ManuelArgibay/BLDC-ESC-PCB/Control Motor BLDC.kicad_pcb

## KiCad design Control Motor BLDC.kicad_pcb (2026-10-14)

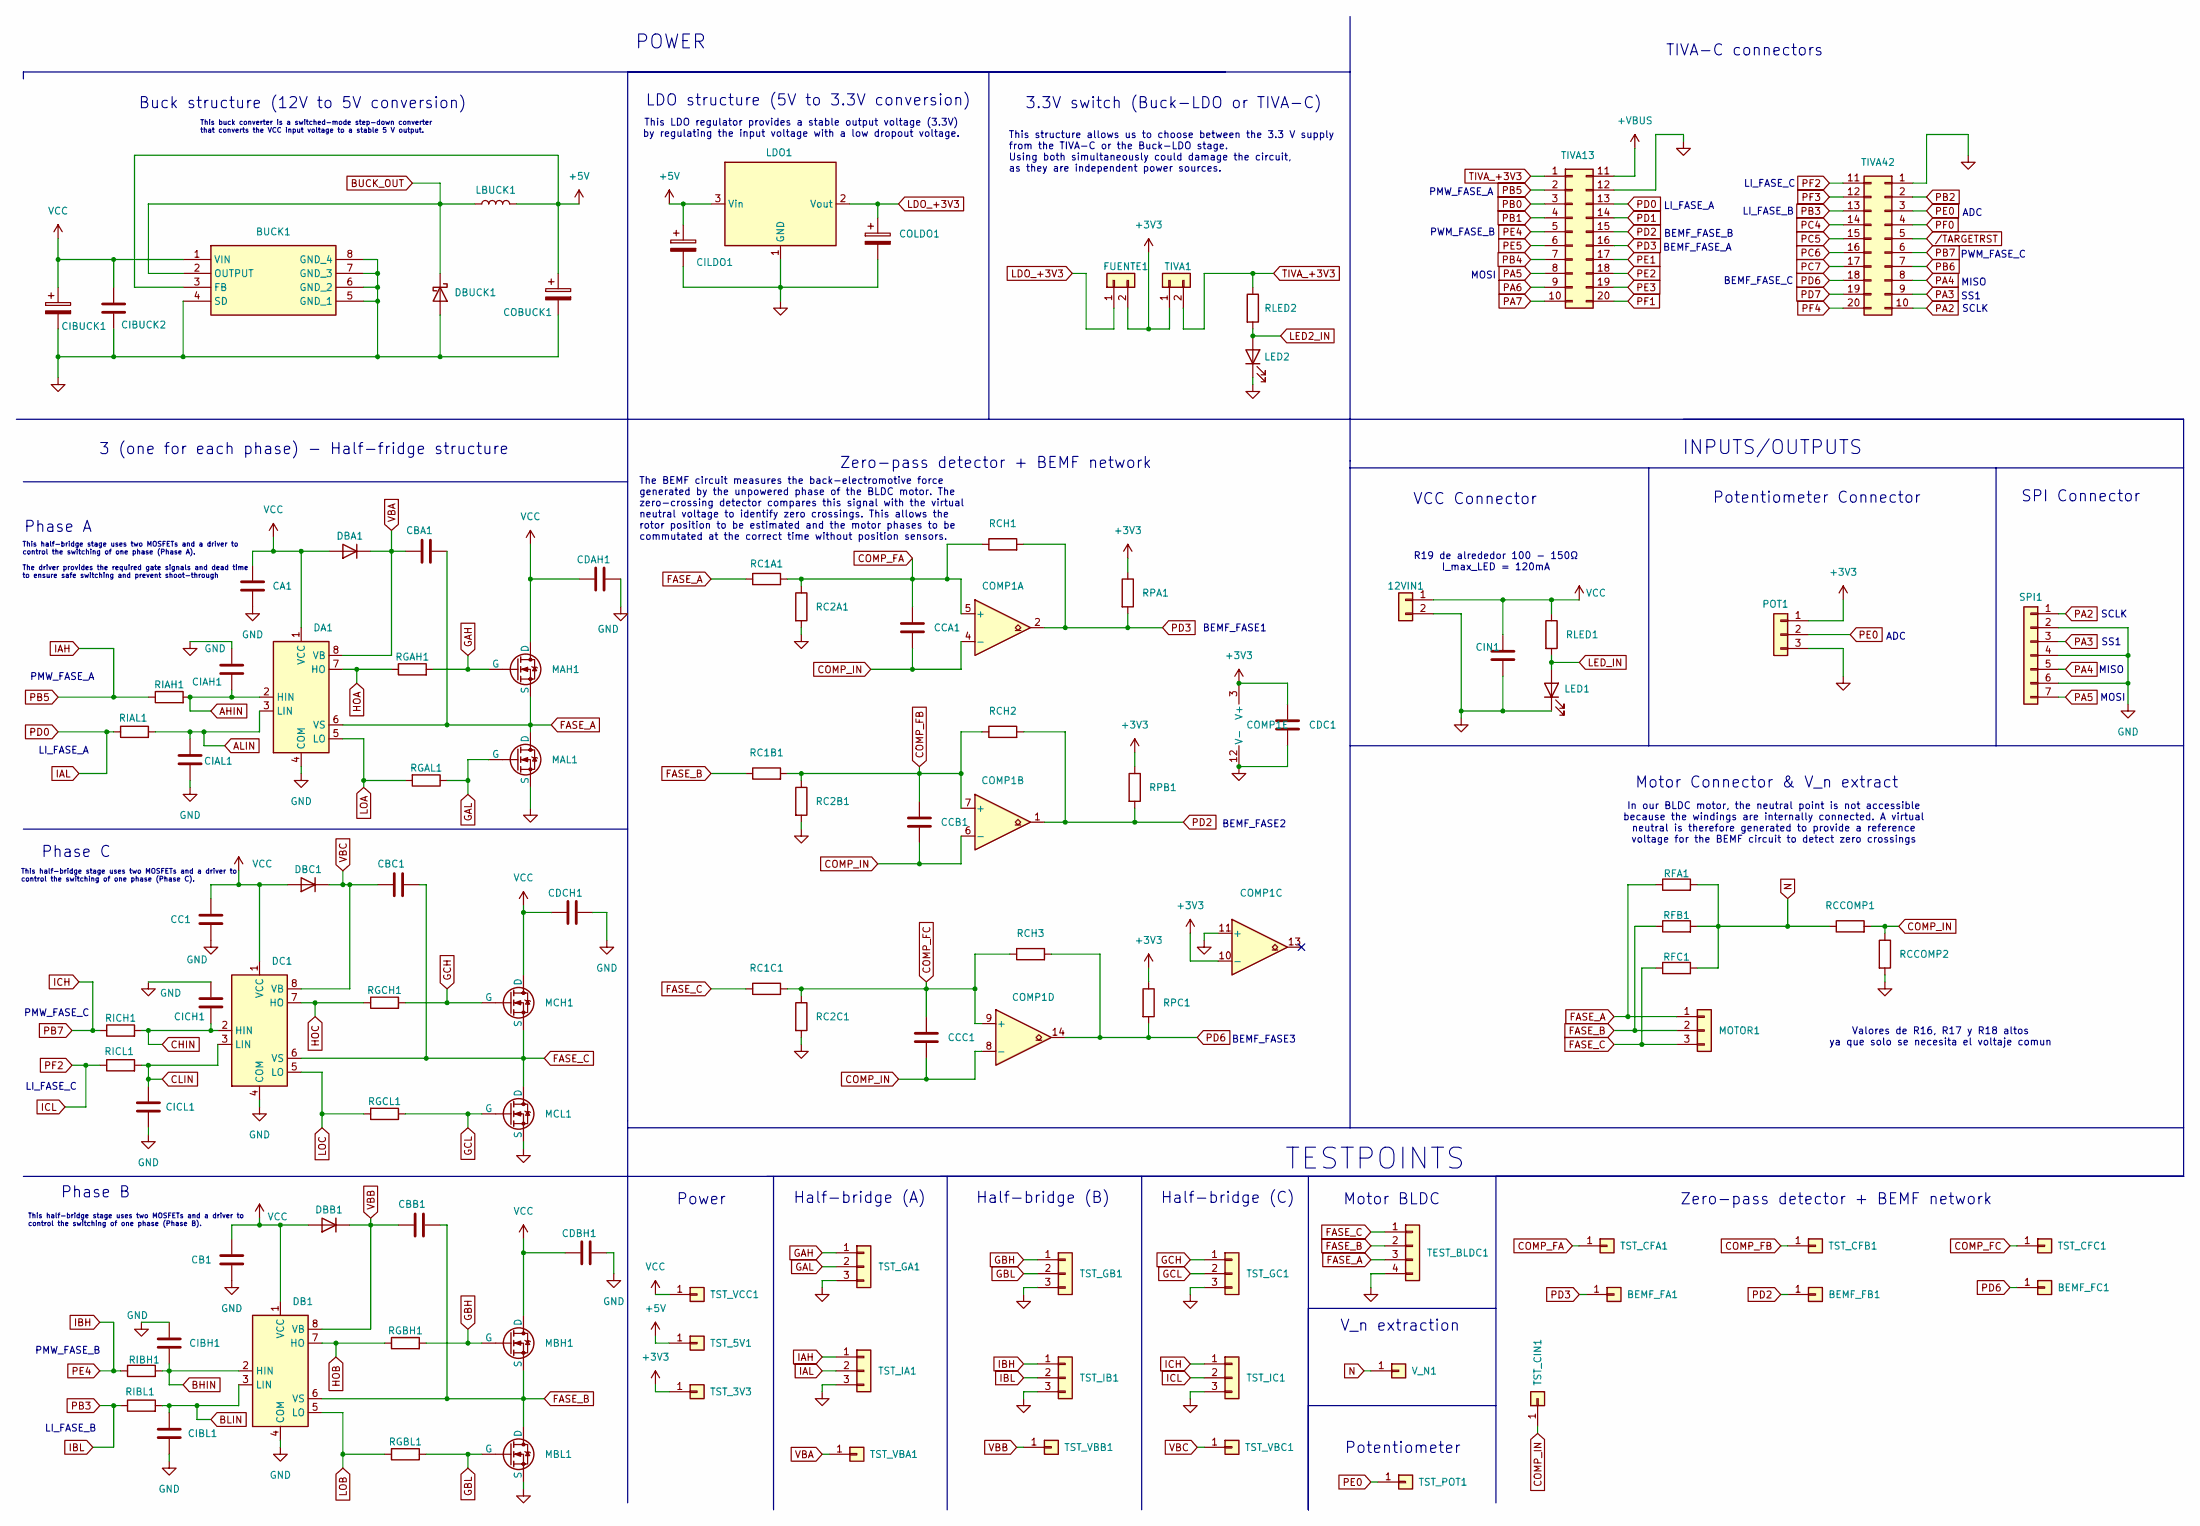
[picture p2: schematic Control Motor BLDC.kicad_sch, Placa LSE Manu & Max]

Parts:
12VIN1: Conn_01x02; TerminalBlock_Phoenix_MKDS-1,5-2-5.08_1x02_P5.08mm_Horizont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
BEMF_FA1: Conn_01x01; PinSocket_1x01_P2.54mm_Vertical
BEMF_FB1: Conn_01x01; PinSocket_1x01_P2.54mm_Vertical
BEMF_FC1: Conn_01x01; PinSocket_1x01_P2.54mm_Vertical
BUCK1: AP1509-50SG-13; SOP-8_3.76x4.96mm_P1.27mm; Mouser Part Number 621-AP1509-50SG-13
CA1: C; C_1206_3216Metric
CB1: C; C_1206_3216Metric
CBA1: C; C_1206_3216Metric
CBB1: C; C_1206_3216Metric
CBC1: C; C_1206_3216Metric
CC1: C; C_1206_3216Metric
CCA1: C; C_1206_3216Metric
CCB1: C; C_1206_3216Metric
CCC1: C; C_1206_3216Metric
CDAH1: C; C_1206_3216Metric
CDBH1: C; C_1206_3216Metric
CDC1: C; C_1206_3216Metric
CDCH1: C; C_1206_3216Metric
CIAH1: C; C_1206_3216Metric
CIAL1: C; C_1206_3216Metric
CIBH1: C; C_1206_3216Metric
CIBL1: C; C_1206_3216Metric
CIBUCK1: C_Polarized; CP_Elec_8x6.2
CIBUCK2: C; C_1206_3216Metric
CICH1: C; C_1206_3216Metric
CICL1: C; C_1206_3216Metric
CILDO1: C_Polarized; C_1206_3216Metric
CIN1: C; CP_Elec_8x6.2
COBUCK1: C_Polarized; CP_Elec_8x6.2
COLDO1: C_Polarized; C_1206_3216Metric
COMP1: LM339; SOIC-14_3.9x8.7mm_P1.27mm
DA1: IR2301; SOIC-8_3.9x4.9mm_P1.27mm
DB1: IR2301; SOIC-8_3.9x4.9mm_P1.27mm
DBA1: 1N4149; D_DO-35_SOD27_P7.62mm_Horizontal
DBB1: 1N4149; D_DO-35_SOD27_P7.62mm_Horizontal
DBC1: 1N4149; D_DO-35_SOD27_P7.62mm_Horizontal
DBUCK1: B220; D_SMB
DC1: IR2301; SOIC-8_3.9x4.9mm_P1.27mm
FUENTE1: Conn_01x02; PinHeader_1x02_P2.54mm_Vertical
LBUCK1: 47µH; Inductor
LDO1: LMS8117; SOT-223-3_TabPin2
LED1, LED2: LED; LED_D3.0mm
MAH1: NMOS
MAL1: NMOS
MBH1: NMOS
MBL1: NMOS
MCH1: NMOS
MCL1: NMOS
MOTOR1: Conn_01x03; TerminalBlock_Phoenix_MKDS-1,5-3-5.08_1x03_P5.08mm_Horizont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
POT1: Conn_01x03; TerminalBlock_Phoenix_MKDS-1,5-3-5.08_1x03_P5.08mm_Horizont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
RC1A1, RC1B1, RC1C1, RC2A1, RC2B1, RC2C1: R; R_1206_3216Metric
RCCOMP1, RCCOMP2: R; R_1206_3216Metric
RCH1, RCH2, RCH3: R; R_1206_3216Metric
RFA1: R; R_1206_3216Metric
RFB1: R; R_1206_3216Metric
RFC1: R; R_1206_3216Metric
RGAH1: R; R_1206_3216Metric
RGAL1: R; R_1206_3216Metric
RGBH1: R; R_1206_3216Metric
RGBL1: R; R_1206_3216Metric
RGCH1: R; R_1206_3216Metric
RGCL1: R; R_1206_3216Metric
RIAH1: R; R_1206_3216Metric
RIAL1: R; R_1206_3216Metric
RIBH1: R; R_1206_3216Metric
RIBL1: R; R_1206_3216Metric
RICH1: R; R_1206_3216Metric
RICL1: R; R_1206_3216Metric
RLED1, RLED2: R; R_1206_3216Metric
RPA1: R; R_1206_3216Metric
RPB1: R; R_1206_3216Metric
RPC1: R; R_1206_3216Metric
SPI1: Conn_01x07; PinHeader_1x07_P2.54mm_Vertical
TEST_BLDC1: Conn_01x04; PinHeader_1x04_P2.54mm_Vertical
TIVA1: Conn_01x02; PinHeader_1x02_P2.54mm_Vertical
TIVA13, TIVA42: Conn_02x10_Top_Bottom; PinSocket_2x10_P2.54mm_Vertical
TST_3V3, TST_5V1: Conn_01x01; PinSocket_1x01_P2.54mm_Vertical
TST_CFA1: Conn_01x01; PinSocket_1x01_P2.54mm_Vertical
TST_CFB1: Conn_01x01; PinSocket_1x01_P2.54mm_Vertical
TST_CFC1: Conn_01x01; PinSocket_1x01_P2.54mm_Vertical
TST_CIN1: Conn_01x01; PinSocket_1x01_P2.54mm_Vertical
TST_GA1: Conn_01x03; PinSocket_1x03_P2.54mm_Vertical
TST_GB1: Conn_01x03; PinSocket_1x03_P2.54mm_Vertical
TST_GC1: Conn_01x03; PinSocket_1x03_P2.54mm_Vertical
TST_IA1: Conn_01x03; PinSocket_1x03_P2.54mm_Vertical
TST_IB1: Conn_01x03; PinSocket_1x03_P2.54mm_Vertical
TST_IC1: Conn_01x03; PinSocket_1x03_P2.54mm_Vertical
TST_POT1: Conn_01x01; PinSocket_1x01_P2.54mm_Vertical
TST_VBA1: Conn_01x01; PinSocket_1x01_P2.54mm_Vertical
TST_VBB1: Conn_01x01; PinSocket_1x01_P2.54mm_Vertical
TST_VBC1: Conn_01x01; PinSocket_1x01_P2.54mm_Vertical
TST_VCC1: Conn_01x01; PinSocket_1x01_P2.54mm_Vertical
V_N1: Conn_01x01; PinSocket_1x01_P2.54mm_Vertical

Connections:
+3V3: CDC1.1, COMP1.3 (V+), COMP1.10 (-), FUENTE1.2, POT1.1, RPA1.1, RPB1.1, RPC1.1, TIVA1.1, TST_3V3.1
+5V: BUCK1.3 (FB), CILDO1.1, COBUCK1.1, LBUCK1.2, LDO1.3 (Vin), TST_5V1.1
+VBUS: TIVA13.11
AHIN: CIAH1.2, DA1.2 (HIN), RIAH1.2
ALIN: CIAL1.2, DA1.3 (LIN), RIAL1.2
BHIN: CIBH1.2, DB1.2 (HIN), RIBH1.2
BLIN: CIBL1.2, DB1.3 (LIN), RIBL1.2
BUCK_OUT: BUCK1.2 (OUTPUT), DBUCK1.1 (K), LBUCK1.1
CHIN: CICH1.2, DC1.2 (HIN), RICH1.2
CLIN: CICL1.2, DC1.3 (LIN), RICL1.2
COMP_FA: CCA1.1, COMP1.5 (+), RC1A1.2, RC2A1.1, RCH1.1, TST_CFA1.1
COMP_FB: CCB1.1, COMP1.7 (+), RC1B1.2, RC2B1.1, RCH2.1, TST_CFB1.1
COMP_FC: CCC1.1, COMP1.9 (+), RC1C1.2, RC2C1.1, RCH3.1, TST_CFC1.1
COMP_IN: CCA1.2, CCB1.2, CCC1.2, COMP1.4 (-), COMP1.6 (-), COMP1.8 (-), RCCOMP1.2, RCCOMP2.1, TST_CIN1.1
FASE_A: CBA1.2, DA1.6 (VS), MAH1.3 (S), MAL1.1 (D), MOTOR1.1, RC1A1.1, RFA1.1, TEST_BLDC1.3
FASE_B: CBB1.2, DB1.6 (VS), MBH1.3 (S), MBL1.1 (D), MOTOR1.2, RC1B1.1, RFB1.1, TEST_BLDC1.2
FASE_C: CBC1.2, DC1.6 (VS), MCH1.3 (S), MCL1.1 (D), MOTOR1.3, RC1C1.1, RFC1.1, TEST_BLDC1.1
GAH: MAH1.2 (G), RGAH1.2, TST_GA1.1
GAL: MAL1.2 (G), RGAL1.1, TST_GA1.2
GBH: MBH1.2 (G), RGBH1.2, TST_GB1.1
GBL: MBL1.2 (G), RGBL1.1, TST_GB1.2
GCH: MCH1.2 (G), RGCH1.2, TST_GC1.1
GCL: MCL1.2 (G), RGCL1.1, TST_GC1.2
GND: 12VIN1.2, BUCK1.4 (SD), BUCK1.5 (GND_1), BUCK1.6 (GND_2), BUCK1.7 (GND_3), BUCK1.8 (GND_4), CA1.2, CB1.1, CC1.1, CDAH1.2, CDBH1.2, CDC1.2, CDCH1.2, CIAH1.1, CIAL1.1, CIBH1.1, CIBL1.1, CIBUCK1.2, CIBUCK2.2, CICH1.1, CICL1.1, CILDO1.2, CIN1.2, COBUCK1.2, COLDO1.2, COMP1.11 (+), COMP1.12 (V-), DA1.4 (COM), DB1.4 (COM), DBUCK1.2 (A), DC1.4 (COM), LDO1.1 (GND), LED1.1 (K), LED2.1 (K), MAL1.3 (S), MBL1.3 (S), MCL1.3 (S), POT1.3, RC2A1.2, RC2B1.2, RC2C1.2, RCCOMP2.2, SPI1.2, SPI1.4, SPI1.6, TEST_BLDC1.4, TIVA13.12, TIVA42.1, TST_GA1.3, TST_GB1.3, TST_GC1.3, TST_IA1.3, TST_IB1.3, TST_IC1.3
HOA: DA1.7 (HO), RGAH1.1
HOB: DB1.7 (HO), RGBH1.1
HOC: DC1.7 (HO), RGCH1.1
IAH: RIAH1.1, TIVA13.2, TST_IA1.1
IAL: RIAL1.1, TIVA13.13, TST_IA1.2
IBH: RIBH1.1, TIVA13.5, TST_IB1.1
IBL: RIBL1.1, TIVA42.13, TST_IB1.2
ICH: RICH1.1, TIVA42.6, TST_IC1.1
ICL: RICL1.1, TIVA42.11, TST_IC1.2
LDO_+3V3: COLDO1.1, FUENTE1.1, LDO1.2 (Vout)
LED2_IN: LED2.2 (A), RLED2.2
LED_IN: LED1.2 (A), RLED1.2
LOA: DA1.5 (LO), RGAL1.2
LOB: DB1.5 (LO), RGBL1.2
LOC: DC1.5 (LO), RGCL1.2
N: RCCOMP1.1, RFA1.2, RFB1.2, RFC1.2, V_N1.1
PA2: SPI1.1, TIVA42.10
PA3: SPI1.3, TIVA42.9
PA4: SPI1.5, TIVA42.8
PA5: SPI1.7, TIVA13.8
PA6: TIVA13.9
PA7: TIVA13.10
PB0: TIVA13.3
PB1: TIVA13.4
PB2: TIVA42.2
PB4: TIVA13.7
PB6: TIVA42.7
PC4: TIVA42.14
PC5: TIVA42.15
PC6: TIVA42.16
PC7: TIVA42.17
PD1: TIVA13.14
PD2: BEMF_FB1.1, COMP1.1, RCH2.2, RPB1.2, TIVA13.15
PD3: BEMF_FA1.1, COMP1.2, RCH1.2, RPA1.2, TIVA13.16
PD6: BEMF_FC1.1, COMP1.14, RCH3.2, RPC1.2, TIVA42.18
PD7: TIVA42.19
PE0: POT1.2, TIVA42.3, TST_POT1.1
PE1: TIVA13.17
PE2: TIVA13.18
PE3: TIVA13.19
PE5: TIVA13.6
PF0: TIVA42.4
PF1: TIVA13.20
PF3: TIVA42.12
PF4: TIVA42.20
TIVA_+3V3: RLED2.1, TIVA1.2, TIVA13.1
VBA: CBA1.1, DA1.8 (VB), DBA1.1 (K), TST_VBA1.1
VBB: CBB1.1, DB1.8 (VB), DBB1.1 (K), TST_VBB1.1
VBC: CBC1.1, DBC1.1 (K), DC1.8 (VB), TST_VBC1.1
VCC: 12VIN1.1, BUCK1.1 (VIN), CA1.1, CB1.2, CC1.2, CDAH1.1, CDBH1.1, CDCH1.1, CIBUCK1.1, CIBUCK2.1, CIN1.1, DA1.1 (VCC), DB1.1 (VCC), DBA1.2 (A), DBB1.2 (A), DBC1.2 (A), DC1.1 (VCC), MAH1.1 (D), MBH1.1 (D), MCH1.1 (D), RLED1.1, TST_VCC1.1; also elsewhere on the board
/TARGETRST: TIVA42.5

Notes on the sheet:
Buck structure (12V to 5V conversion)
Half-bridge (A)
Phase C
Potentiometer Connector
LI_FASE_A
Phase A
Half-bridge (B)
SS1
PMW_FASE_A
PMW_FASE_C
Phase B
ADC
SPI Connector
The BEMF circuit measures the back-electromotive force generated by the unpowered phase of the BLDC motor. The zero-crossing detector compares this signal with the virtual neutral voltage to identify zero crossings. This allows the rotor position to be estimated and the motor phases to be commutate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
This half-bridge stage uses two MOSFETs and a driver to control the switching of one phase (Phase C).
Power
This structure allows us to choose between the 3.3 V supply from the TIVA-C or the Buck-LDO stage. Using both simultaneously could damage the circuit, as they are independent power sources.
MISO
Valores de R16, R17 y R18 altos ya que solo se necesita el voltaje comun
TESTPOINTS
SCLK
TIVA-C connectors
3.3V switch (Buck-LDO or TIVA-C)
BEMF_FASE_A
MOSI
VCC Connector
PWM_FASE_B
This half-bridge stage uses two MOSFETs and a driver to control the switching of one phase (Phase A). The driver provides the required gate signals and dead time to ensure safe switching and prevent shoot-through
BEMF_FASE2
Potentiometer
PWM_FASE_C
R19 de alrededor 100 - 150Ω I_max_LED = 120mA
3 (one for each phase) - Half-fridge structure
LI_FASE_C
BEMF_FASE_C
Motor Connector & V_n extract
This buck converter is a switched-mode step-down converter that converts the VCC input voltage to a stable 5 V output.
This half-bridge stage uses two MOSFETs and a driver to control the switching of one phase (Phase B).
LI_FASE_B
POWER
This LDO regulator provides a stable output voltage (3.3V) by regulating the input voltage with a low dropout voltage.
Motor BLDC
Zero-pass detector + BEMF network
BEMF_FASE1
In our BLDC motor, the neutral point is not accessible because the windings are internally connected. A virtual neutral is therefore generated to provide a reference voltage for the BEMF circuit to detect zero crossings
LDO structure (5V to 3.3V conversion)
Half-bridge (C)
PMW_FASE_B
BEMF_FASE3
V_n extraction
INPUTS/OUTPUTS
BEMF_FASE_B

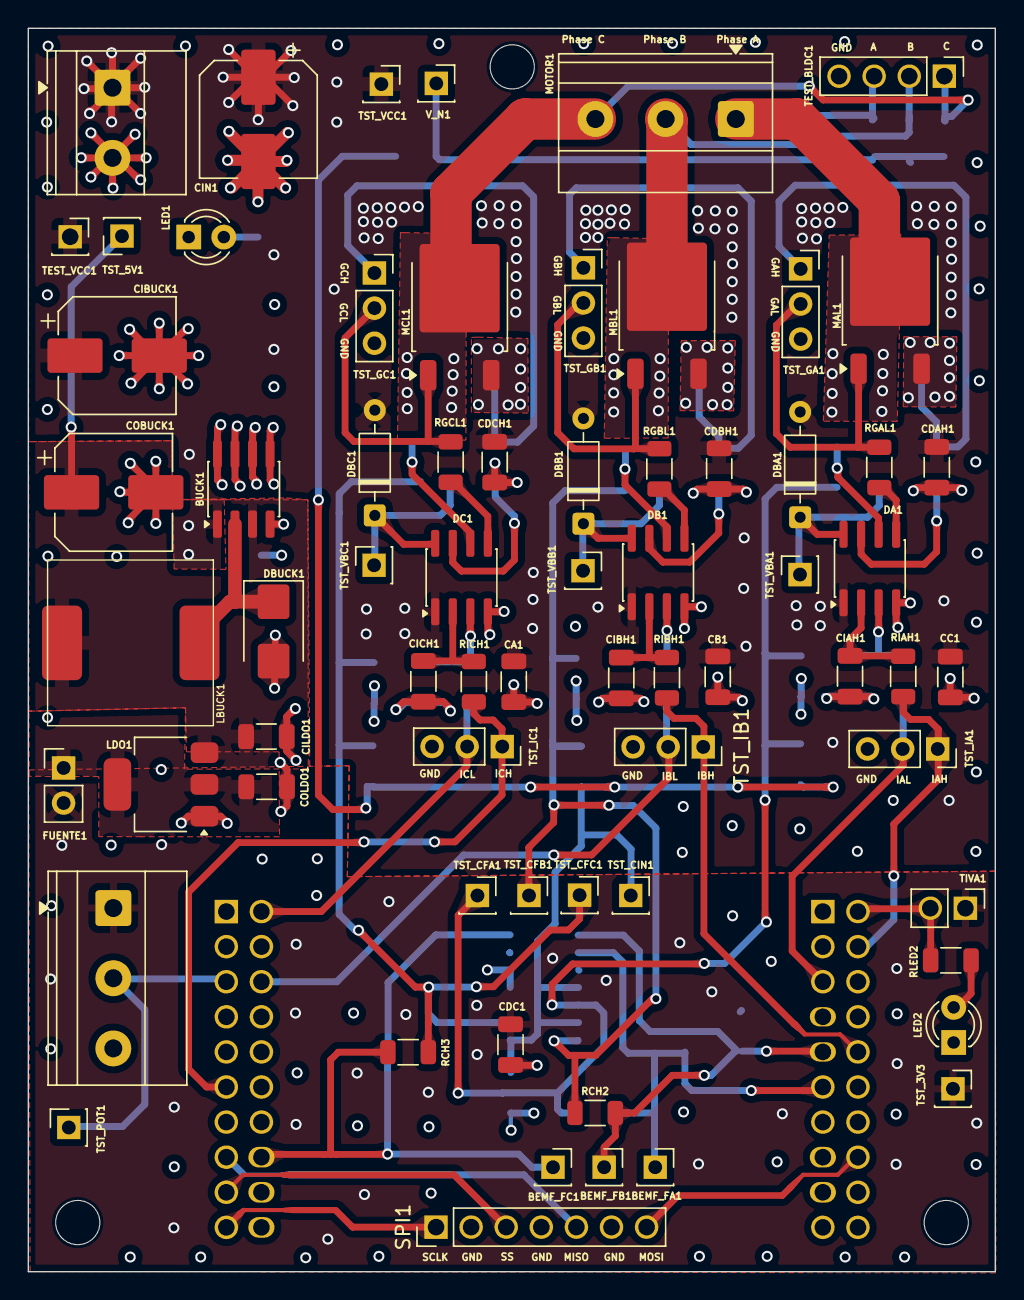
[picture p3: board Control Motor BLDC.kicad_pcb from above]

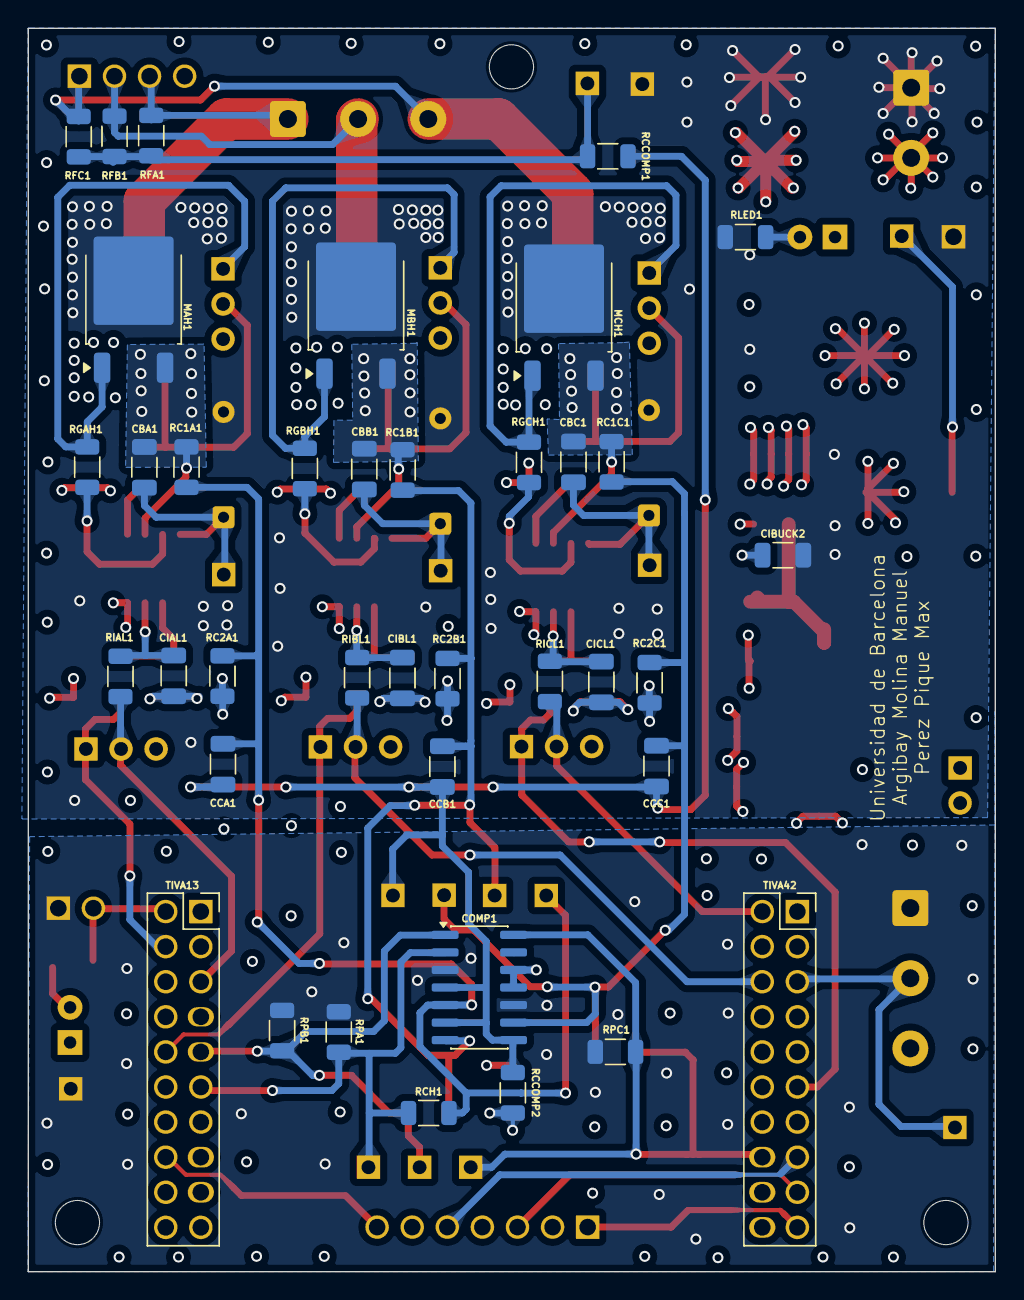
[picture p4: board Control Motor BLDC.kicad_pcb from below]

Board: 4 copper layers, 70.0 x 90.0 mm, 106 parts (38 on the bottom side), 52 nets.

Other parts of the board:
TEST_VCC1: Conn_01x01; PinSocket_1x01_P2.54mm_Vertical

Their connections:
VCC: TEST_VCC1.1; also elsewhere on the board
