ManuelArgibay/BLDC-ESC-PCB/(commit log)

2026-10-10 Proyecto KiCad del controlador BLDC sensorless (ESC) y README
    Claude-Session: https://claude.ai/code/session_013r4B2srvJtMjRWPG8WW6dN
2026-10-11 Update proyecto KiCad - revision esquematico
2026-10-12 Elimino schematics innecesarios
2026-10-12 Corrijo errores de la placa (0 errors, 0 warnings)
2026-10-18 Update
    Se ha acabado la funcion init_GPIOs e init_sys. Falta la de init_clocks y probar el PWM.
    Se ha hecho con defines. Todo esta comentado
2026-10-21 Firmware: añade init_PWM, PWM() e init_ADC; registros como punteros desreferenciados
    Actualiza LSE-BLDC_control/main.c con la versión local: configuración de
    pines BEMF (PD2/PD3/PD6) como entradas, PB5/PB7/PE4 con función alternativa
    PWM vía PCTL, generador PWM0 a 32 kHz y ADC0 SS3 sobre PE0 (AIN3).
    Ignora carpetas de build de CCS y referencia el firmware en el README.
    Claude-Session: https://claude.ai/code/session_01M3CgmtKxjwTcGyZum7vybv
2026-10-21 Revert "Firmware: añade init_PWM, PWM() e init_ADC; registros como punteros desreferenciados"
    This reverts commit d0f4eadc08ba15a8b3380cbd842c68fc28e94704.
